sai-ydev/pi_day_2025/pi_day_2025_top_bom.xlsx

Comment | Designator | Footprint | LCSC Part #
0 | R14 R16 | 0402 | C17168
0.1uF | C1 C2 C3 C4 C5 C6 C7 C8 C9 C10 C11 C12 C13 C16 C17 C18 C19 C26 C27 C28 C29 C30 C31 C32 C33 C34 C38 C40 C45 C46 C48 C49 C50 C51 C52 | 0402 | C1525
1.0uF | C14 C15 C43 C44 | 0402 | C14445
1K | R5 R15 | 0402 | C11702
1N5819HW-7 | D12 | SOD3715X145N | C2100
2.2K | R6 R7 | 0402 | C25879
2.2uF | C20 | 0402 | C12530
2.2nH | L1 | INDC1608X100N | C113061
2.2uH | L3 L4 | INDC2016X100N | C86093
3.3uH | L2 | IND_LQH2MCN120K02L | C42411119
4.7uF | C35 C36 C37 C39 | 0402 | C23733
10k | R1 R3 R23 R25 | 0402 | C25531
10uF | C21 C22 C23 C24 C25 | 0402 | C15525
10uF | C47 | 0402-TIGHT | C15525
12MHz | Y1 | CRYSTAL-SMD-3.2X2.5MM | C20625731
12pF | C41 C42 | 0402 | C1547
27 | R12 R13 | 0402 | C3017771
33 | R11 | 0402 | C25105
47K | R9 | 0402 | C25563
100K | R22 | 0402 | C25530
100OHM | R2 | 0402 | C25076
310mA/60V/1.6Î© | Q2 | SOT323 | C12298
470K | R10 | 0402 | C25562
APS6404L-3SQR-ZR | U1 | APS6404L-3SQR-ZR | C3040877
BLUE | D11 | LED-0603 | C2286
DNF | R4 | 0402 | DNF
EAST1616RGYA0 | LED1 | EAST1616RGYA0 | C19171339
ESP32-C3-MINI-1-N4 | U9 | XCVR_ESP32-C3-MINI-1-N4 | C2934569
JS202011JCQN | S3 | SW_JS202011JCQN | C221665
JST-PH-2 | J1 | JST-2-SMD | C295747
LSM6DS3TR-C | U6 | LGA-14-2.5X3MM | C967633
MLT-8530 | LS1 | CUI_CSS-0575A-SMT | C94599
MOMENTARY-SWITCH-SPST-SMD-4.6X2.8MM | S1 S2 S4 | TACTILE_SWITCH_SMD_4.6X2.8MM | C72443
NPM1300-QEAA-R | IC2 | QFN50P500X500X90-33N | C7466043
Qwiic | J2 | 1X04_1MM_RA | SM04B-SRSS-TB(LF)(SN)
RP2350A | U2 | RP2350A | C42411118
SK6812-EJ | D1 D2 D3 D4 D5 D6 D7 D8 D9 D10 | LED_SK6812-E | C5149201
SM03B-SRSS-TB(LF)(SN) | J4 | JST_SM03B-SRSS-TB(LF)(SN) | C160403
SN74LVC1T45DBVRG4 | U15 | SOT95P280X145-6N | C7843
SPK2611HM7H-1-6 | MK1 | MIC_SPK2611HM7H-1-6 | C22407811
TPB1 27 | 1.8V | B1 27 | DNF
TPB1 27 | 3.3V | B1 27 | DNF
TPB1 27 | GND | B1 27 | DNF
TPB1 27 | VBATT | B1 27 | DNF
TPB1 27 | VBUS | B1 27 | DNF
TPB1 27 | VSYS | B1 27 | DNF
TPB1 27 | V_USB_OUT | B1 27 | DNF
TXS0108EPWRG4 | U5 | SOP65P640X120-20N | C17206
TYPE-C-31-M-12 | CONN1 | HRO_TYPE-C-31-M-12 | C165948
W25Q64JVXGIQ | IC1 | SON80P400X400X50-9N | C2940195
XTSD04GLGEAG | U3 | SON127P600X800X95-8N | C7429714
