sai-ydev/pi_day_2025/pi_day_2025.brd

## EAGLE design pi_day_2025.brd (2025-03-15)

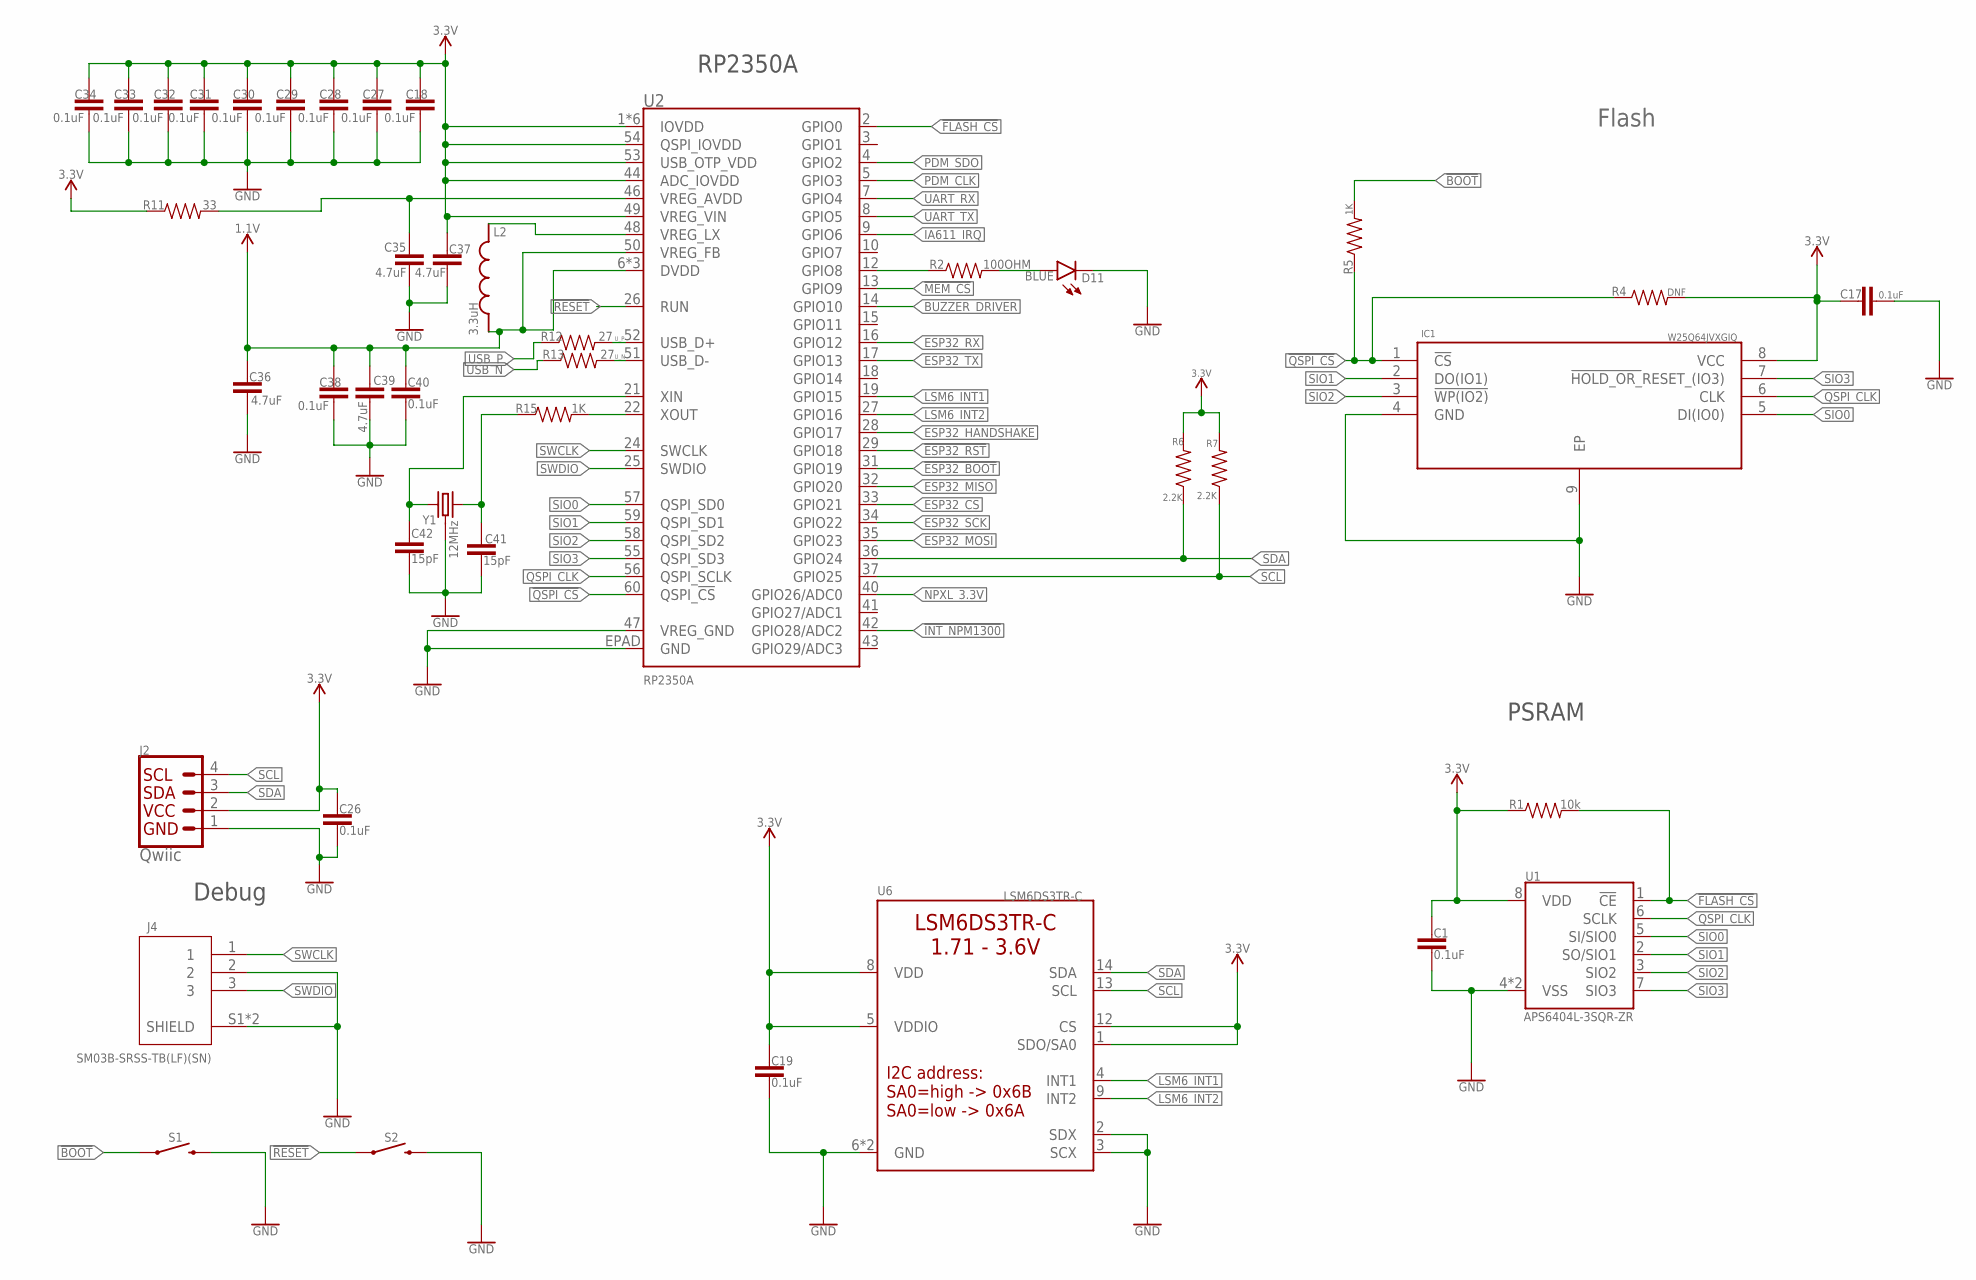
[picture p1: schematic pi_day_2025.sch, sheet 1]

Parts:
C1, C17, C18, C19, C26, C27, C28, C29, C30, C31, C32, C33, C34, C38, C40: 0.1uF; 0402
C35, C36, C37, C39: 4.7uF; 0402
C41, C42: 15pF; 0402
D11: BLUE; LED-0603
IC1: W25Q64JVXGIQ; SON80P400X400X50-9N
J2: Qwiic; 1X04_1MM_RA
J4: SM03B-SRSS-TB(LF)(SN); JST_SM03B-SRSS-TB(LF)(SN)
L2: 3.3uH; IND_LQH2MCN120K02L
R1: 10k; 0402
R2: 100OHM; 0402
R4: DNF; 0402
R5, R15: 1K; 0402
R6, R7: 2.2K; 0402
R11: 33; 0402
R12, R13: 27; 0402
S1, S2: MOMENTARY-SWITCH-SPST-SMD-4.6X2.8MM; TACTILE_SWITCH_SMD_4.6X2.8MM
U1: APS6404L-3SQR-ZR
U2: RP2350A
U6: LSM6DS3TR-C; LGA-14-2.5X3MM
Y1: 12MHz; CRYSTAL-SMD-3.2X2.5MM

Connections:
1.1V: C36.1, C38.1, C39.1, C40.1, L2.1, U2.6 (DVDD), U2.23 (DVDD), U2.39 (DVDD), U2.50 (VREG_FB)
3.3V: C1.1, C17.1, C18.1, C19.1, C26.1, C27.1, C28.1, C29.1, C30.1, C31.1, C32.1, C33.1, C34.1, C37.1, IC1.8 (VCC), J2.2, R1.1, R4.2, R6.2, R7.2, R11.1, U1.8 (VDD), U2.1 (IOVDD), U2.11 (IOVDD), U2.20 (IOVDD), U2.30 (IOVDD), U2.38 (IOVDD), U2.44 (ADC_IOVDD), U2.45 (IOVDD), U2.49 (VREG_VIN), U2.53 (USB_OTP_VDD), U2.54 (QSPI_IOVDD), U6.1 (SDO/SA0), U6.5 (VDDIO), U6.8 (VDD), U6.12 (CS); also elsewhere on the board
!BOOT: R5.2, S1.1, S1.2 (1)
!ESP32_BOOT: U2.31 (GPIO19); also elsewhere on the board
!ESP32_RST: U2.29 (GPIO18); also elsewhere on the board
!FLASH_CS: R1.2, U1.1 (!CE!), U2.2 (GPIO0)
!INT_NPM1300: U2.42 (GPIO28/ADC2); also elsewhere on the board
!MEM_CS: U2.13 (GPIO9); also elsewhere on the board
!QSPI_CS: IC1.1 (!CS), R4.1, R5.1, U2.60 (QSPI_!CS!)
!RESET: S2.1, S2.2 (1), U2.26 (RUN)
BUZZER_DRIVER: U2.14 (GPIO10); also elsewhere on the board
ESP32_CS: U2.33 (GPIO21); also elsewhere on the board
ESP32_HANDSHAKE: U2.28 (GPIO17); also elsewhere on the board
ESP32_MISO: U2.32 (GPIO20); also elsewhere on the board
ESP32_MOSI: U2.35 (GPIO23); also elsewhere on the board
ESP32_RX: U2.16 (GPIO12); also elsewhere on the board
ESP32_SCK: U2.34 (GPIO22); also elsewhere on the board
ESP32_TX: U2.17 (GPIO13); also elsewhere on the board
GND: C1.2, C17.2, C18.2, C19.2, C26.2, C27.2, C28.2, C29.2, C30.2, C31.2, C32.2, C33.2, C34.2, C35.2, C36.2, C37.2, C38.2, C39.2, C40.2, C41.2, C42.2, D11.C, IC1.4 (GND), IC1.9 (EP), J2.1, J4.2, J4.S1 (SHIELD), J4.S2 (SHIELD), S1.3 (2), S1.4 (2), S2.3 (2), S2.4 (2), U1.4 (VSS), U1.9 (VSS), U2.47 (VREG_GND), U2.EPAD (GND), U6.2 (SDX), U6.3 (SCX), U6.6 (GND), U6.7 (GND), Y1.2 (GND), Y1.4 (GND); also elsewhere on the board
IA611_IRQ: U2.9 (GPIO6); also elsewhere on the board
LSM6_INT1: U2.19 (GPIO15), U6.4 (INT1)
LSM6_INT2: U2.27 (GPIO16), U6.9 (INT2)
unnamed: R2.1, U2.12 (GPIO8)
unnamed: C35.1, R11.2, U2.46 (VREG_AVDD)
unnamed: D11.A, R2.2
unnamed: L2.2, U2.48 (VREG_LX)
unnamed: C41.1, R15.1, Y1.3 (2)
unnamed: C42.1, U2.21 (XIN), Y1.1
unnamed: R15.2, U2.22 (XOUT)
NPXL_3.3V: U2.40 (GPIO26/ADC0); also elsewhere on the board
PDM_CLK: U2.5 (GPIO3); also elsewhere on the board
PDM_SDO: U2.4 (GPIO2); also elsewhere on the board
QSPI_CLK: IC1.6 (CLK), U1.6 (SCLK), U2.56 (QSPI_SCLK)
SCL: J2.4, R7.1, U2.37 (GPIO25), U6.13 (SCL); also elsewhere on the board
SDA: J2.3, R6.1, U2.36 (GPIO24), U6.14 (SDA); also elsewhere on the board
SIO0: IC1.5 (DI(IO0)), U1.5 (SI/SIO0), U2.57 (QSPI_SD0)
SIO1: IC1.2 (DO(IO1)), U1.2 (SO/SIO1), U2.59 (QSPI_SD1)
SIO2: IC1.3 (!WP(IO2)), U1.3 (SIO2), U2.58 (QSPI_SD2)
SIO3: IC1.7 (!HOLD_OR_!RESET_(IO3)), U1.7 (SIO3), U2.55 (QSPI_SD3)
SWCLK: J4.1, U2.24 (SWCLK)
SWDIO: J4.3, U2.25 (SWDIO)
UART_RX: U2.7 (GPIO4); also elsewhere on the board
UART_TX: U2.8 (GPIO5); also elsewhere on the board
USB_N: R13.1; also elsewhere on the board
USB_P: R12.1; also elsewhere on the board
U_N: R13.2, U2.51 (USB_D-)
U_P: R12.2, U2.52 (USB_D+)

Notes on the sheet:
RP2350A
PSRAM
Flash
Debug

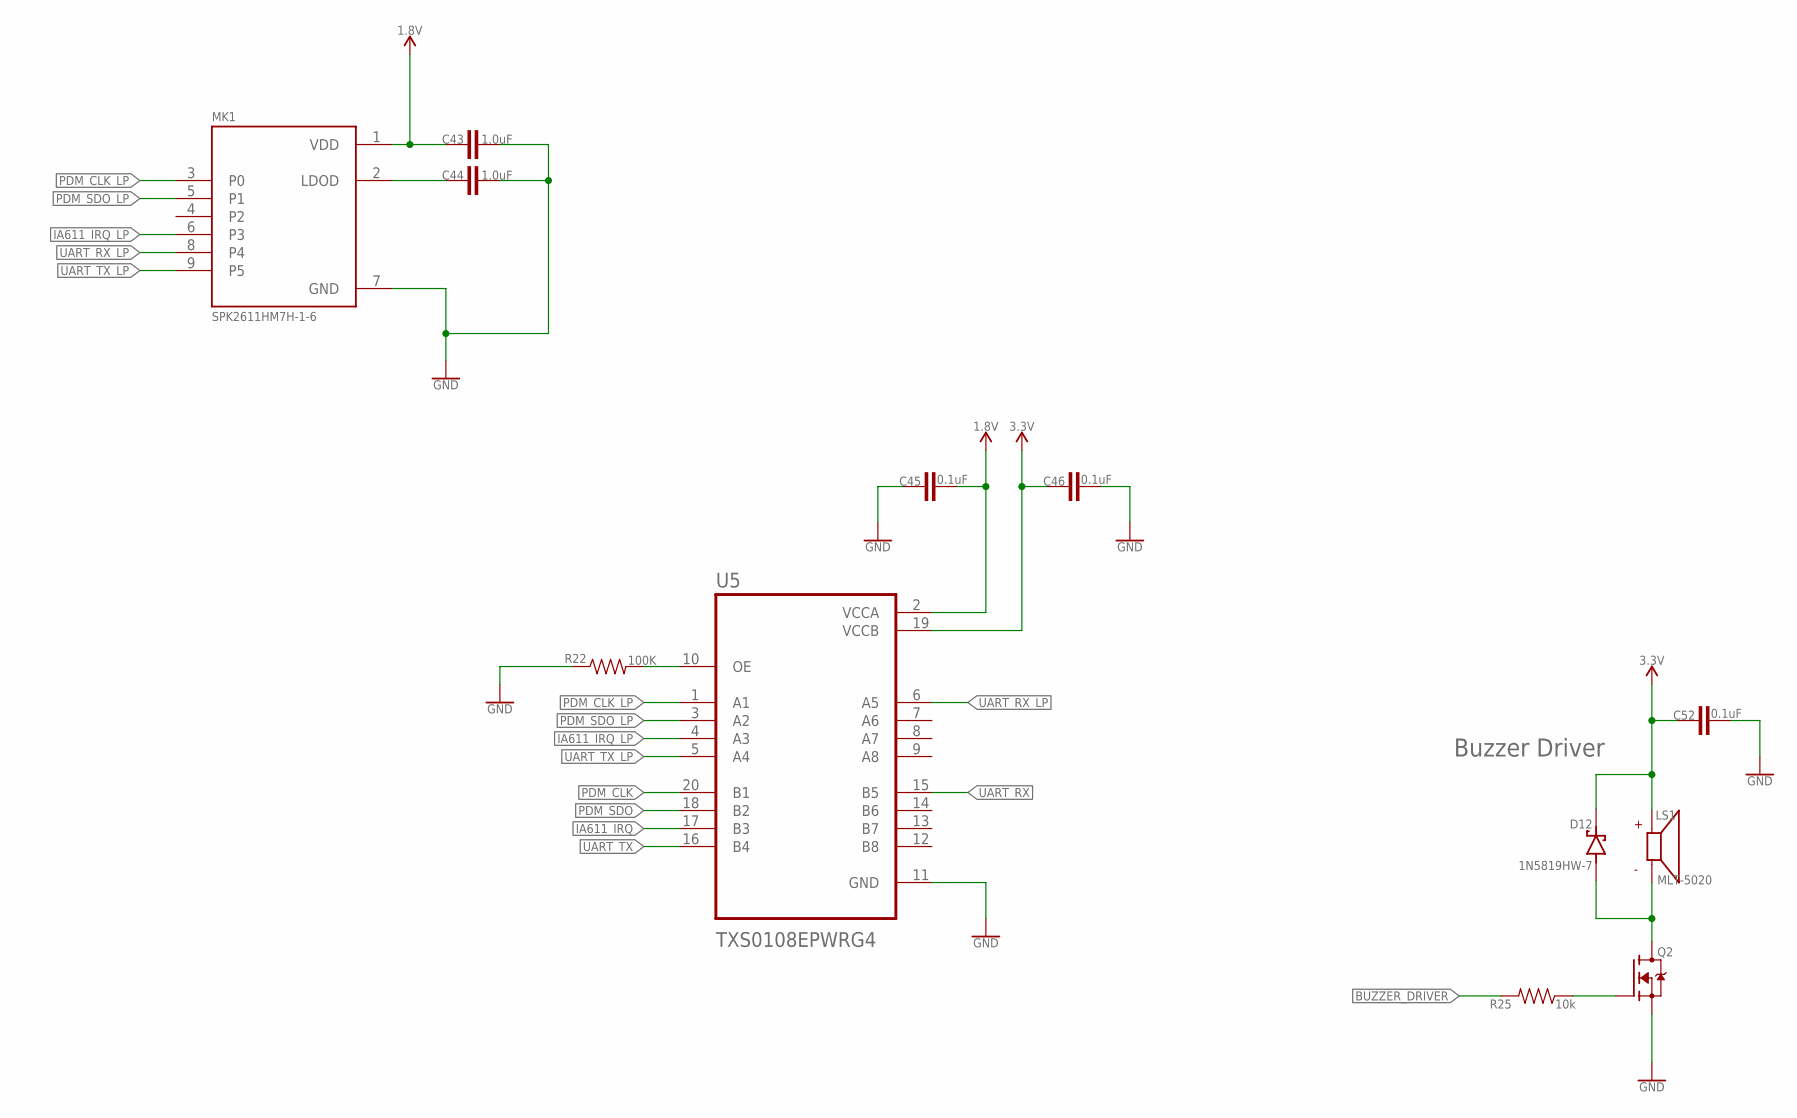
[picture p2: schematic pi_day_2025.sch, sheet 2]

Parts:
C43, C44: 1.0uF; 0402
C45, C46, C52: 0.1uF; 0402
D12: 1N5819HW-7; SOD3715X145N
LS1: MLT-5020; XDCR_CMT-8504-100-SMT-TR
MK1: SPK2611HM7H-1-6; MIC_SPK2611HM7H-1-6
Q2: BSS138; SOT95P240X111-3N
R22: 100K; 0402
R25: 10k; 0402
U5: TXS0108EPWRG4; SOP65P640X120-20N

Connections:
1.8V: C43.1, C45.2, MK1.1 (VDD), U5.2 (VCCA); also elsewhere on the board
3.3V: C46.1, C52.1, D12.C (K), LS1.P, U5.19 (VCCB); also elsewhere on the board
BUZZER_DRIVER: R25.2; also elsewhere on the board
GND: C43.2, C44.2, C45.1, C46.2, C52.2, MK1.7 (GND), Q2.2 (S), R22.1, U5.11 (GND); also elsewhere on the board
IA611_IRQ: U5.17 (B3); also elsewhere on the board
IA611_IRQ_LP: MK1.6 (P3), U5.4 (A3)
unnamed: C44.1, MK1.2 (LDOD)
unnamed: R22.2, U5.10 (OE)
unnamed: D12.A, LS1.N, Q2.3 (D)
unnamed: Q2.1 (G), R25.1
PDM_CLK: U5.20 (B1); also elsewhere on the board
PDM_CLK_LP: MK1.3 (P0), U5.1 (A1)
PDM_SDO: U5.18 (B2); also elsewhere on the board
PDM_SDO_LP: MK1.5 (P1), U5.3 (A2)
UART_RX: U5.15 (B5); also elsewhere on the board
UART_RX_LP: MK1.8 (P4), U5.6 (A5)
UART_TX: U5.16 (B4); also elsewhere on the board
UART_TX_LP: MK1.9 (P5), U5.5 (A4)

Notes on the sheet:
Buzzer Driver

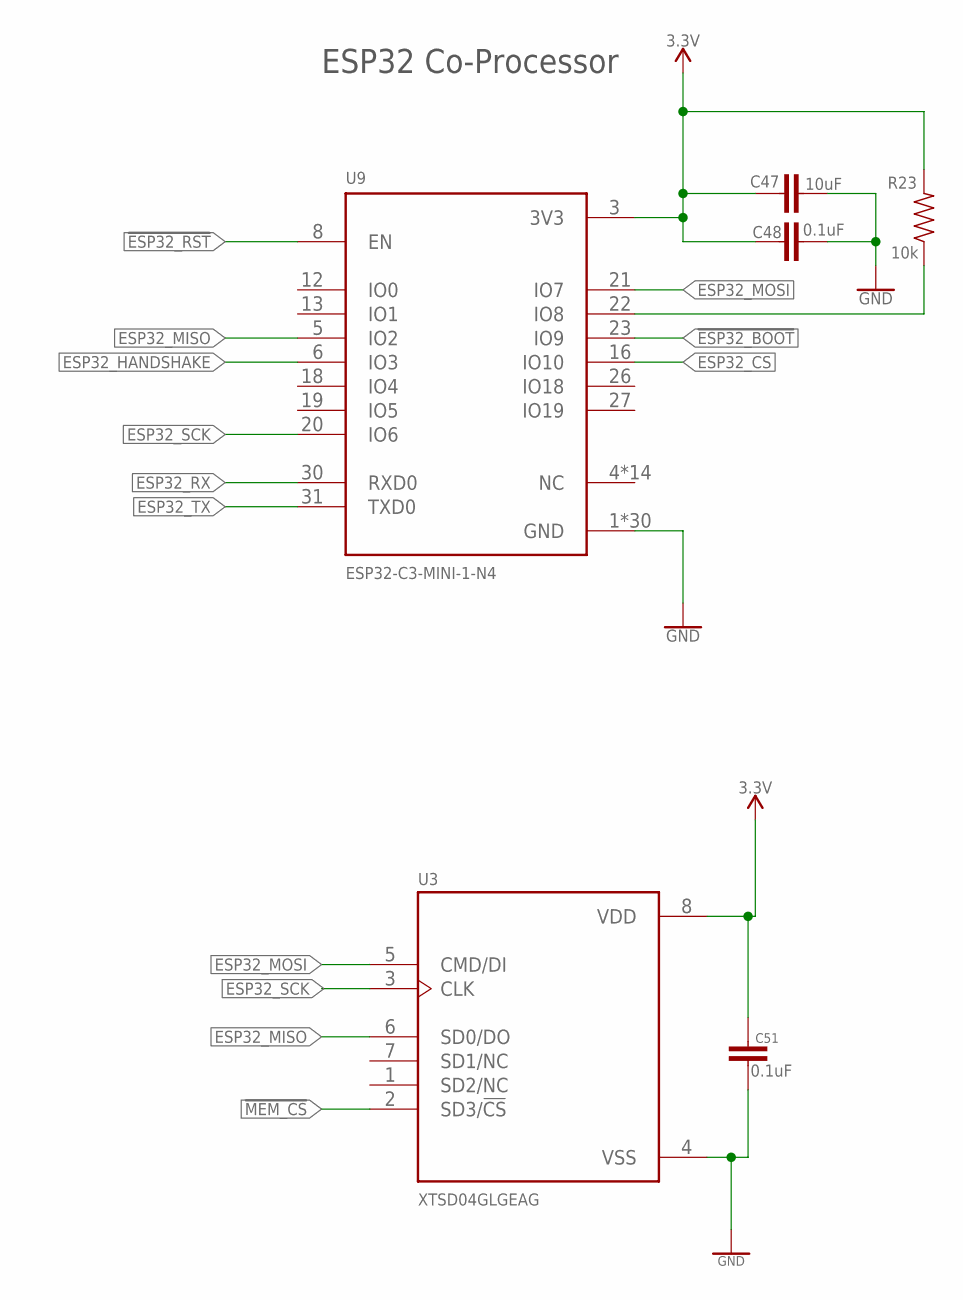
[picture p3: schematic pi_day_2025.sch, sheet 3]

Parts:
C47: 10uF; 0402-TIGHT
C48, C51: 0.1uF; 0402
R23: 10k; 0402
U3: XTSD04GLGEAG; SON127P600X800X95-8N
U9: ESP32-C3-MINI-1-N4; XCVR_ESP32-C3-MINI-1-N4

Connections:
3.3V: C47.1, C48.1, C51.2, R23.2, U3.8 (VDD), U9.3 (3V3); also elsewhere on the board
!ESP32_BOOT: U9.23 (IO9); also elsewhere on the board
!ESP32_RST: U9.8 (EN); also elsewhere on the board
!MEM_CS: U3.2 (SD3/!CS); also elsewhere on the board
ESP32_CS: U9.16 (IO10); also elsewhere on the board
ESP32_HANDSHAKE: U9.6 (IO3); also elsewhere on the board
ESP32_MISO: U3.6 (SD0/DO), U9.5 (IO2); also elsewhere on the board
ESP32_MOSI: U3.5 (CMD/DI), U9.21 (IO7); also elsewhere on the board
ESP32_RX: U9.30 (RXD0); also elsewhere on the board
ESP32_SCK: U3.3 (CLK), U9.20 (IO6); also elsewhere on the board
ESP32_TX: U9.31 (TXD0); also elsewhere on the board
GND: C47.2, C48.2, C51.1, U3.4 (VSS), U9.1 (GND), U9.2 (GND), U9.11 (GND), U9.14 (GND), U9.36 (GND), U9.37 (GND), U9.38 (GND), U9.39 (GND), U9.40 (GND), U9.41 (GND), U9.42 (GND), U9.43 (GND), U9.44 (GND), U9.45 (GND), U9.46 (GND), U9.47 (GND), U9.48 (GND), U9.49_1 (GND), U9.49_2 (GND), U9.49_3 (GND), U9.49_4 (GND), U9.49_5 (GND), U9.49_6 (GND), U9.49_7 (GND), U9.49_8 (GND), U9.49_9 (GND), U9.50 (GND), U9.51 (GND), U9.52 (GND), U9.53 (GND); also elsewhere on the board
unnamed: R23.1, U9.22 (IO8)

Notes on the sheet:
ESP32 Co-Processor

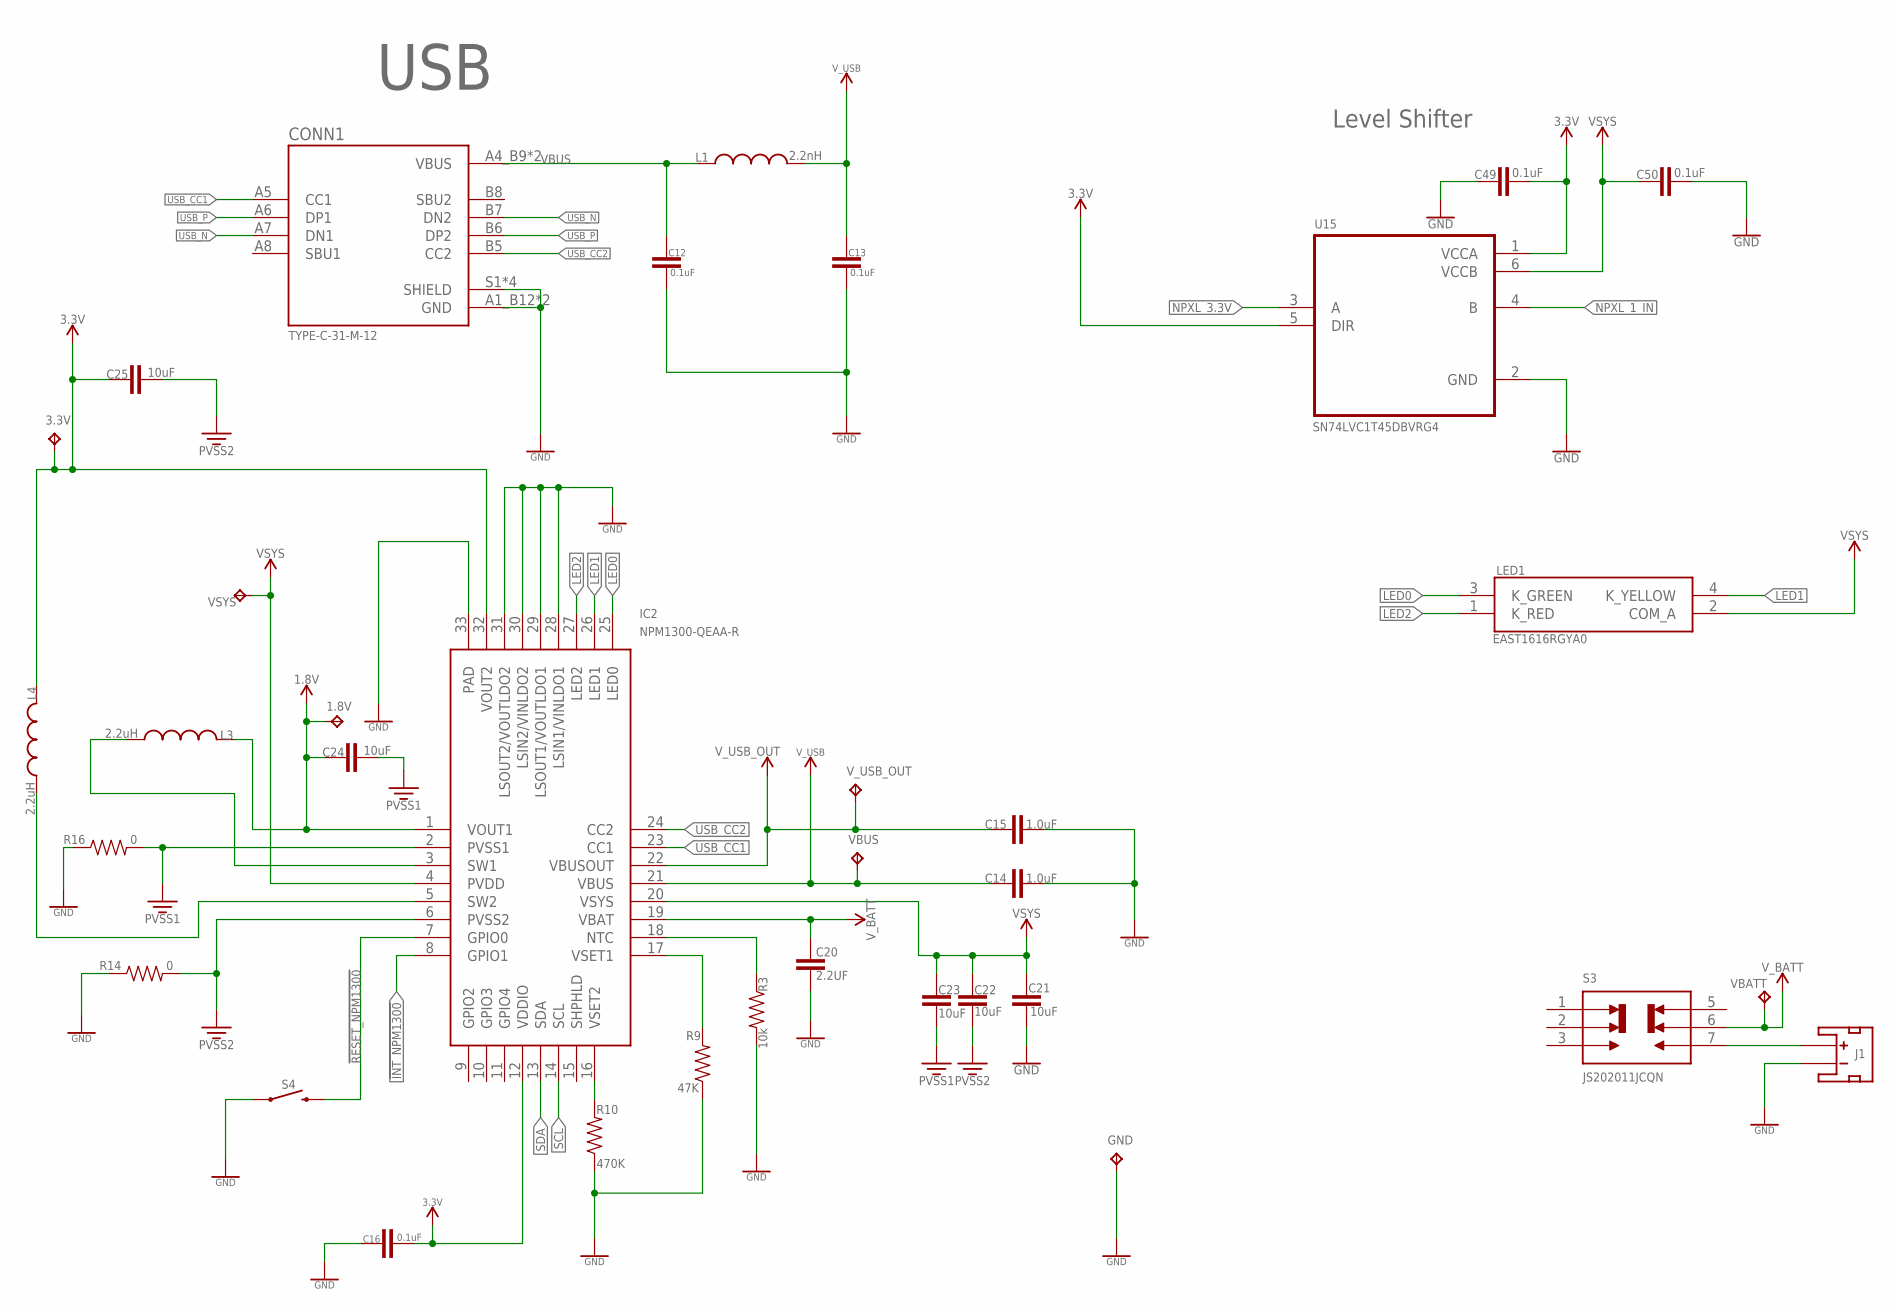
[picture p4: schematic pi_day_2025.sch, sheet 4]

Parts:
1.8V, 3.3V: TPB1,27; B1,27
C12, C13, C16, C49, C50: 0.1uF; 0402
C14, C15: 1.0uF; 0402
C20: 2.2UF; 0402
C21, C22, C23, C24, C25: 10uF; 0402
CONN1: TYPE-C-31-M-12; HRO_TYPE-C-31-M-12
GND: TPB1,27; B1,27
IC2: NPM1300-QEAA-R; QFN50P500X500X90-33N
J1: JST-PH=2; JST-2-SMD
L1: 2.2nH; INDC1608X100N
L3, L4: 2.2uH; INDC2016X100N
LED1: EAST1616RGYA0
R3: 10k; 0402
R9: 47K; 0402
R10: 470K; 0402
R14, R16: 0; 0402
S3: JS202011JCQN; SW_JS202011JCQN
S4: MOMENTARY-SWITCH-SPST-SMD-4.6X2.8MM; TACTILE_SWITCH_SMD_4.6X2.8MM
U15: SN74LVC1T45DBVRG4; SOT95P280X145-6N
VBATT: TPB1,27; B1,27
VBUS: TPB1,27; B1,27
VSYS: TPB1,27; B1,27
V_USB_OUT: TPB1,27; B1,27

Connections:
1.8V: 1.8V.TP, C24.1, IC2.1 (VOUT1), L3.2; also elsewhere on the board
3.3V: 3.3V.TP, C16.2, C25.1, C49.2, IC2.12 (VDDIO), IC2.32 (VOUT2), L4.2, U15.1 (VCCA), U15.5 (DIR); also elsewhere on the board
!INT_NPM1300: IC2.8 (GPIO1); also elsewhere on the board
!RESET_NPM1300: IC2.7 (GPIO0), S4.3 (2), S4.4 (2)
GND: C12.2, C13.2, C14.2, C15.2, C16.1, C20.2, C21.2, C49.1, C50.2, CONN1.A1_B12 (GND), CONN1.B1_A12 (GND), CONN1.S1 (SHIELD), CONN1.S2 (SHIELD), CONN1.S3 (SHIELD), CONN1.S4 (SHIELD), GND.TP, IC2.28 (LSIN1/VINLDO1), IC2.29 (LSOUT1/VOUTLDO1), IC2.30 (LSIN2/VINLDO2), IC2.31 (LSOUT2/VOUTLDO2), IC2.33 (PAD), J1.1 (-), R3.2, R9.1, R10.1, R14.1, R16.1, S4.1, S4.2 (1), U15.2 (GND); also elsewhere on the board
LED0: IC2.25 (LED0), LED1.3 (K_GREEN)
LED1: IC2.26 (LED1), LED1.4 (K_YELLOW)
LED2: IC2.27 (LED2), LED1.1 (K_RED)
unnamed: IC2.18 (NTC), R3.1
unnamed: IC2.16 (VSET2), R10.2
unnamed: IC2.17 (VSET1), R9.2
unnamed: J1.2 (+), S3.7
unnamed: IC2.3 (SW1), L3.1
unnamed: IC2.5 (SW2), L4.1
NPXL_1_IN: U15.4 (B); also elsewhere on the board
NPXL_3.3V: U15.3 (A); also elsewhere on the board
PVSS1: C23.2, C24.2, IC2.2 (PVSS1), R16.2
PVSS2: C22.2, C25.2, IC2.6 (PVSS2), R14.2
SCL: IC2.14 (SCL); also elsewhere on the board
SDA: IC2.13 (SDA); also elsewhere on the board
USB_CC1: CONN1.A5 (CC1), IC2.23 (CC1)
USB_CC2: CONN1.B5 (CC2), IC2.24 (CC2)
USB_N: CONN1.A7 (DN1), CONN1.B7 (DN2); also elsewhere on the board
USB_P: CONN1.A6 (DP1), CONN1.B6 (DP2); also elsewhere on the board
VBUS: C12.1, CONN1.A4_B9 (VBUS), CONN1.B4_A9 (VBUS), L1.1
VSYS: C21.1, C22.1, C23.1, C50.1, IC2.4 (PVDD), IC2.20 (VSYS), LED1.2 (COM_A), U15.6 (VCCB), VSYS.TP; also elsewhere on the board
V_BATT: C20.1, IC2.19 (VBAT), S3.6, VBATT.TP
V_USB: C13.1, C14.1, IC2.21 (VBUS), L1.2, VBUS.TP
V_USB_OUT: C15.1, IC2.22 (VBUSOUT), V_USB_OUT.TP

Notes on the sheet:
USB
Level Shifter

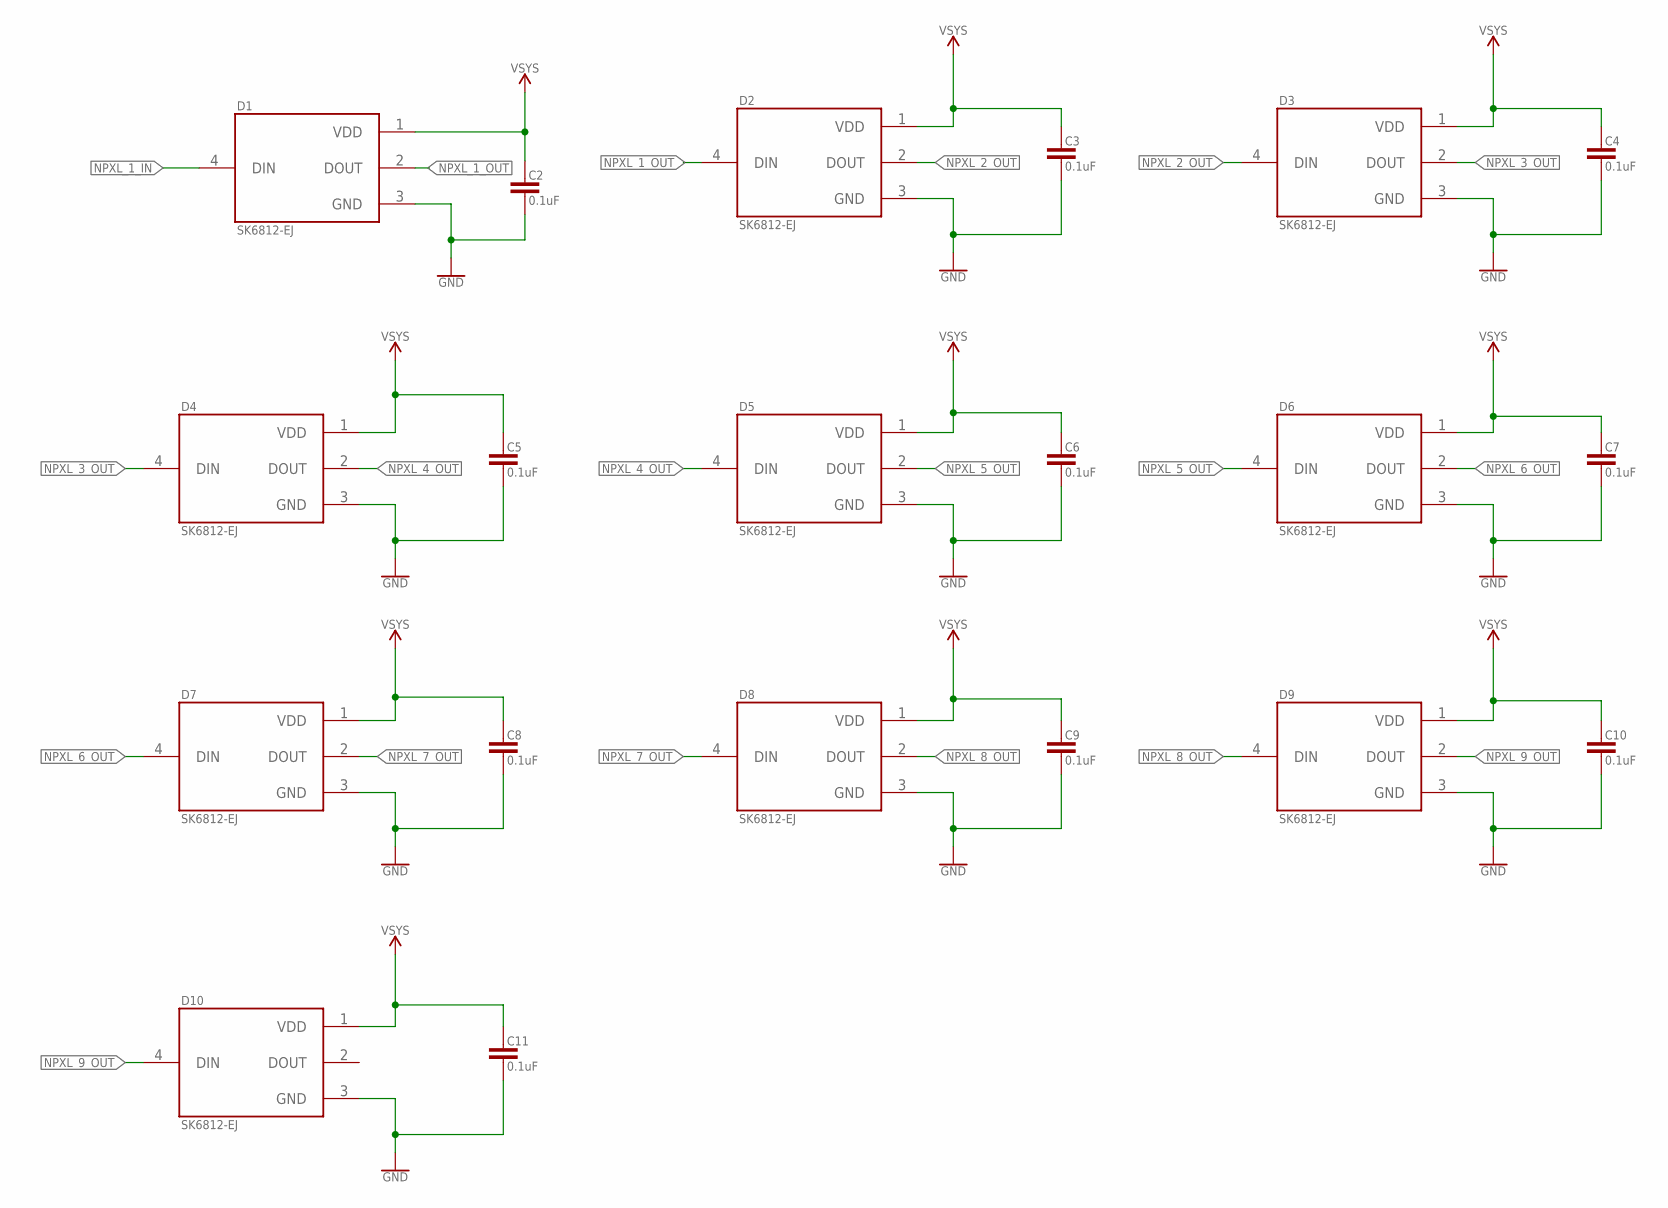
[picture p5: schematic pi_day_2025.sch, sheet 5]

Parts:
C2, C3, C4, C5, C6, C7, C8, C9, C10, C11: 0.1uF; 0402
D1, D2, D3, D4, D5, D6, D7, D8, D9, D10: SK6812-EJ; LED_SK6812-E

Connections:
GND: C2.2, C3.2, C4.2, C5.2, C6.2, C7.2, C8.2, C9.2, C10.2, C11.2, D1.3 (GND), D2.3 (GND), D3.3 (GND), D4.3 (GND), D5.3 (GND), D6.3 (GND), D7.3 (GND), D8.3 (GND), D9.3 (GND), D10.3 (GND); also elsewhere on the board
NPXL_1_IN: D1.4 (DIN); also elsewhere on the board
NPXL_1_OUT: D1.2 (DOUT), D2.4 (DIN)
NPXL_2_OUT: D2.2 (DOUT), D3.4 (DIN)
NPXL_3_OUT: D3.2 (DOUT), D4.4 (DIN)
NPXL_4_OUT: D4.2 (DOUT), D5.4 (DIN)
NPXL_5_OUT: D5.2 (DOUT), D6.4 (DIN)
NPXL_6_OUT: D6.2 (DOUT), D7.4 (DIN)
NPXL_7_OUT: D7.2 (DOUT), D8.4 (DIN)
NPXL_8_OUT: D8.2 (DOUT), D9.4 (DIN)
NPXL_9_OUT: D9.2 (DOUT), D10.4 (DIN)
VSYS: C2.1, C3.1, C4.1, C5.1, C6.1, C7.1, C8.1, C9.1, C10.1, C11.1, D1.1 (VDD), D2.1 (VDD), D3.1 (VDD), D4.1 (VDD), D5.1 (VDD), D6.1 (VDD), D7.1 (VDD), D8.1 (VDD), D9.1 (VDD), D10.1 (VDD); also elsewhere on the board

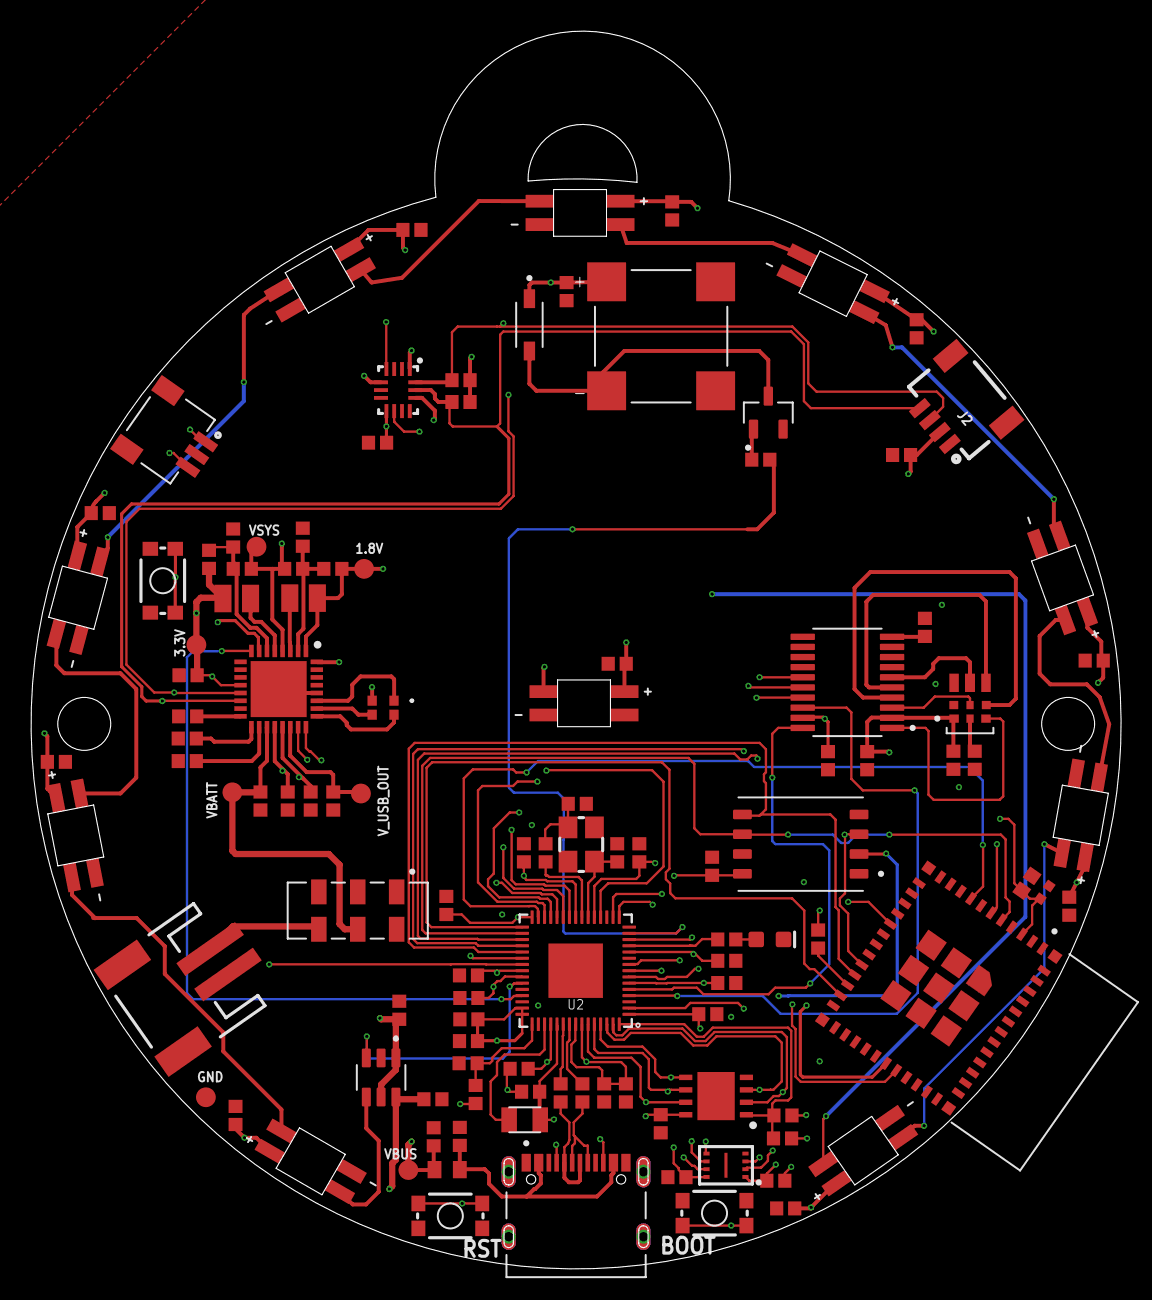
[picture p6: board pi_day_2025.brd from above]

Board: 4 copper layers, 70.0 x 79.5 mm, 115 parts (0 on the bottom side), 87 nets.
