sai-ydev/pi_day_2025/(commit log)

2025-01-16 design file check-in
    [pi_day_2025.brd, pi_day_2025.sch]
2025-01-18 Updates to design
    [pi_day_2025.brd, pi_day_2025.sch]
2025-01-19 File upload
    [pi_day_2025.brd, pi_day_2025.sch]
2025-01-21 Finished power supply design
    [pi_day_2025.brd, pi_day_2025.sch]
2025-01-21 Added 1.8V regulator
    [pi_day_2025.brd, pi_day_2025.sch]
2025-01-21 Added bypass capacitor to IA611
    [pi_day_2025.brd, pi_day_2025.sch]
2025-01-21 additions to txs0108
    [pi_day_2025.brd, pi_day_2025.sch]
2025-01-22 Added pinouts for IA611 & voltage level converter
    [pi_day_2025.brd, pi_day_2025.sch]
2025-01-22 Added PDM microphone
    [pi_day_2025.brd, pi_day_2025.sch]
2025-01-22 Added ESP32 chipset.
    [pi_day_2025.brd, pi_day_2025.sch]
2025-01-23 COmpleted schematic
    [pi_day_2025.brd, pi_day_2025.sch]
2025-01-23 Finished schematic
    [pi_day_2025.brd, pi_day_2025.sch]
2025-03-15 Deleting files
    [pi_day_2025.brd, pi_day_2025.sch]
2025-03-15 Completed Pendant
    [pi_day_2025.brd, pi_day_2025.sch, pi_day_2025_top_bom.csv, pi_day_2025_top_bom.xlsx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]
